eutill/HaDiKo_Humidity_Alarm/(threads)

Thread 1 (2023-11-17):

Board casually resets when trying to read the temperature sensor

eutill, 2023-11-17:
The controller resets when trying to read the temperature sensor.
Here is a log from approx. 70 minutes into normal operation:

```
14:21:08.486 -> RWE	Temperature:20.9 Humidity:75.3
14:21:38.798 -> RWE	Temperature:20.9 Humidity:75.2
14:21:38.862 -> SIL	ALARM NEXT
14:21:38.865 ->
14:21:38.865 -> CTL	Entering state ALARM_PIEZO
14:21:38.894 -> ALA	MAX_CYCLES REACHED
14:21:38.926 ->
14:21:38.926 -> CTL	Entering state ALARM_SILENT
14:22:09.227 -> RWE	Temperature:20.9 Humidity:75.3
14:22:39.543 -> RWE	Temperature:20.9 Humidity:75.2
14:23:09.833 -> RWE	Temperature:20.9 Humidity:75.2
14:23:40.127 -> RWE	Temperature:20.9 Humidity:75.2
14:24:10.427 -> RWE	Temperature:20.9 Humidity:75.2
14:24:40.727 -> RWE	Temperature:20.9 Humidity:75.2
14:25:11.033 -> RWE	Temperature:20.9 Humidity:75.2
14:25:41.327 -> RWE	Temperature:20.9 Humidity:75.2
14:26:11.818 -> STARTUP
14:26:11.818 -> BAT	Battery voltage in mV: 4486.53
14:26:11.884 ->
14:26:11.884 -> CTL	Entering state NO_ALARM
14:26:42.148 -> RWE	Temperature:20.9 Humidity:75.1
14:26:42.214 -> NOA	THR EXC
14:26:42.214 ->
14:26:42.214 -> CTL	Entering state VIGILANCE
14:27:12.509 -> RWE	Temperature:20.9 Humidity:75.1
14:27:42.814 -> RWE	Temperature:21.0 Humidity:75.2
14:27:42.879 -> VIG	ALARM START
14:27:42.884 ->
14:27:42.884 -> CTL	Entering state ALARM_PIEZO
14:27:43.105 -> RWE	Temperature:21.0 Humidity:75.2
14:27:43.138 -> ALA	PIEZO ON
14:27:57.148 -> RWE	Temperature:20.9 Humidity:76.0
14:27:57.180 -> ALA	NEXT SILENT
14:27:57.212 -> ALA	ALARM STOP2
14:27:57.212 ->
14:27:57.212 -> CTL	Entering state ALARM_SILENT
14:28:27.511 -> RWE	Temperature:20.9 Humidity:75.1
14:28:57.810 -> RWE	Temperature:20.9 Humidity:75.1
14:29:28.118 -> RWE	Temperature:20.9 Humidity:75.1
```
The same happened again after approx. one hour.

eutill, 2023-11-17:
In this extreme case, the microcontroller kept resetting numerous times before entering stable operation. Watch how the battery voltage also drops:
```
RWE     Temperature:20.7 Humidity:65.7
RWE     Temperature:20.7 Humidity:65.8
RWE     Temperature:20.7 Humidity:65.8

STARTUP
Reset flags: 100
BAT     Battery voltage in mV: 4471.93

CTL     Entering state NO_ALARM
RWE     Temperature:20.7 Humidity:65.8
NOA     THR EXC

CTL     Entering state VIGILANCE
▒▒▒▒▒▒▒▒▒▒▒
           STARTUP
Reset flags: 100
BAT     Battery voltage in mV: 2972.72

CTL     Entering state NO_ALARM
▒▒▒▒▒▒▒
       STARTUP
Reset flags: 100
BAT     Battery voltage in mV: 3729.17

CTL     Entering state NO_ALARM

STARTUP
Reset flags: 100
BAT     Battery voltage in mV: 3897.98

CTL     Entering state NO_ALARM

STARTUP
Reset flags: 100
BAT     Battery voltage in mV: 4460.07

CTL     Entering state NO_ALARM
RWE     Temperature:20.7 Humidity:65.8
NOA     THR EXC

CTL     Entering state VIGILANCE
RWE     Temperature:20.7 Humidity:65.8
```

eutill, 2023-11-17:
At this point, it was probable that the issue lies in hardware, seeing that the voltage drops when current rises. A look at the battery compartment revealed that a battery contact was corroded. After cleaning, this problem did not arise again.

Closed 2023-11-17.
