eutill/HaDiKo_Humidity_Alarm/HaDiKo_Humidity_Alarm.ino

#include <Adafruit_SSD1306.h>
#include <math.h>
#include <avr/sleep.h>
#include "TempHumSensor.h"


#define ALARM_START_HUMIDITY 65.0f
#define ALARM_END_HUMIDITY 60.0f
#define MEASURE_CYCLE_SEC 60
#define VIGILANCE_DURATION_SEC 60 //should be a multiple of MEASURE_CYCLE_SEC
#define PIEZO_MAX_DURATION_SEC 15 //should be greater than SCREEN_ON_DURATION_SEC
#define PIEZO_OFF_DURATION_SEC 300 //should be a multiple of MEASURE_CYCLE_SEC
#define SCREEN_ON_DURATION_SEC 10
#define MAX_PIEZO_CYCLES 2
#define LOW_BATT_THR 3350.0 //mV, float!

#define PIEZO_PIN 9
#define DISPLAY_VCC_PIN 17
#define DHT_VCC_PIN 16
#define PUSHBUTTON_PIN 2
#define BATT_ADC_PIN A0
#define BATT_VOLT_DIV_GND_PIN 10

//#define APP_DEBUG

#ifdef APP_DEBUG
  #define DEBUG_PRINT(...)		Serial.print(__VA_ARGS__)
  #define DEBUG_PRINTLN(...)		Serial.println(__VA_ARGS__)
#else
  #define DEBUG_PRINT(...)
  #define DEBUG_PRINTLN(...)
#endif


Adafruit_SSD1306 display(128,32);
DHT dht(A1, DHT22);

typedef enum { //don't change order! is being used as index
  STATE_NO_ALARM = 0,
  STATE_VIGILANCE,
  STATE_ALARM_PIEZO,
  STATE_ALARM_SILENT
} alarm_state_t;

const char * alarm_state_str[] = { //don't change order
  "NO_ALARM",
  "VIGILANCE",
  "ALARM_PIEZO",
  "ALARM_SILENT"
};

uint8_t currPiezoCycle = 0;
bool battOk = true;
weatherData_t weather;


bool checkBatt() {
  int i;
  float avgVolt = 0;
  float battVolt;
  unsigned int adcVal;
  analogReference(INTERNAL);
  ADCSRA |= (1 << ADEN);
  pinMode(BATT_VOLT_DIV_GND_PIN, OUTPUT);
  for(i=0;i<10;i++) {
    adcVal = analogRead(BATT_ADC_PIN);
    //discard first five readings due to inaccuracies and average the next 5
    if(i>4) {
      avgVolt += adcVal;
    }
  }
  pinMode(BATT_VOLT_DIV_GND_PIN, INPUT);
  ADCSRA &= ~(1 << ADEN);
  avgVolt /= 5.0;
  avgVolt *= (1080.0/1024.0); //1080 mV is Vref, corresponding to 1024 ADC value
  battVolt = (avgVolt - 22) * 3.32587 + avgVolt; //voltage divider is between Vcc and ~22mV ("GND" on BATT_VOLT_DIV_GND_PIN), 3.32587 is ratio between R1 and R2
  DEBUG_PRINT(F("BAT\tBattery voltage in mV: "));
  DEBUG_PRINTLN(battVolt);

  if(battVolt < LOW_BATT_THR) {
    return false;
  } else {
    return true;
  }
}

bool readWeather(void) {
  pinMode(DHT_VCC_PIN, OUTPUT);
  digitalWrite(DHT_VCC_PIN, HIGH);
  
  dht.begin();
  delay(1000); //DHT needs time to boot

  for(int i=0;i<3;i++) {
    if(dht.readWeather(&weather)) {
      if((weather.humid > 0.0f) && (weather.humid <= 100.0f) && (weather.temp > -20.0f) && (weather.temp < 100.0f)) {
        DEBUG_PRINT(F("RWE\tTemperature:"));
        DEBUG_PRINT(weather.temp, 1);
        DEBUG_PRINT(F(" Humidity:"));
        DEBUG_PRINTLN(weather.humid, 1);

        digitalWrite(DHT_VCC_PIN, LOW);
        pinMode(DHT_VCC_PIN, INPUT);
        return true;
      }
    }
    DEBUG_PRINT(F("RWE\tINV MEAS "));
    DEBUG_PRINTLN(i+1);
    delay(1000);
  }

  digitalWrite(DHT_VCC_PIN, LOW);
  pinMode(DHT_VCC_PIN, INPUT);
  return false;
}

void initScreen(void) {
  display.begin(SSD1306_SWITCHCAPVCC, 0x3C);
  display.clearDisplay();
  display.setTextSize(2);
  display.setTextColor(WHITE);
  display.cp437(true);
  display.setRotation(0);
  display.setCursor(0,0);
  display.clearDisplay();
}

void onOffScreen(bool onOff) {
  if(onOff) {
    pinMode(DISPLAY_VCC_PIN, OUTPUT);
    digitalWrite(DISPLAY_VCC_PIN, LOW); //inverted logic because PNP
    delay(2000); //needs time to boot
    initScreen();
  } else {
    digitalWrite(DISPLAY_VCC_PIN, HIGH); //inverted logic because PNP
    pinMode(DISPLAY_VCC_PIN, INPUT);
    TWCR = 0; //I2C connection reset
    pinMode(18, INPUT);
    digitalWrite(18, LOW);
    pinMode(19, INPUT);
    digitalWrite(19, LOW);
  }
}



void onOffPiezo(bool onOff) {
  if(onOff) {
    pinMode(PIEZO_PIN, OUTPUT);
    digitalWrite(PIEZO_PIN, HIGH);
  } else {
    digitalWrite(PIEZO_PIN, LOW);
    pinMode(PIEZO_PIN, INPUT);
  }
}


ISR(WDT_vect) {}
ISR(INT0_vect) {EIMSK &= ~(1 << INT0);}

bool goToSleep(unsigned int sleepSec) {
#ifdef APP_DEBUG
  Serial.flush();
#endif

  bool buttonPressed = false;

  if (sleepSec < 2) {sleepSec = 2;} //avoid roll-over in next line
  sleepSec = ((sleepSec - 2) / 4) * 4;

  set_sleep_mode(SLEEP_MODE_PWR_DOWN);
  cli();
  //configure watchDog
  MCUSR &= ~(1<<WDRF);
  WDTCSR |= (1<<WDCE) | (1<<WDE);
  WDTCSR = 1<<WDP3; //Watchdog-Dauer (4 sec)
  //configure INT0
  EICRA = (EICRA & ~((1<<ISC00) | (1<<ISC01))); //LOW level interrupt on INT0
  sei();

  //enable watchDog
  WDTCSR |= (1<<WDIE);
  //enable INT0
  EIMSK |= (1<<INT0);

  for(uint8_t i = 0; i<sleepSec/4; i++) {
    cli();
    sleep_enable();
#ifndef APP_DEBUG
    sleep_bod_disable(); //sets BORF in MCUSR - not great for debugging!
#endif
    sei();
    sleep_cpu();
    if(!digitalRead(PUSHBUTTON_PIN)) {
      buttonPressed = true;
      break;
    }
    sleep_disable();
  }
  
  //disable watchDog
  WDTCSR &= ~(1<<WDIE);
  //disable INT0
  EIMSK &= ~(1 << INT0);
  
  if(buttonPressed) {
    DEBUG_PRINTLN(F("SLP\tButton pressed!"));
    onOffPiezo(false);
  }
  
  //returns bool that describes cause of wakeup
  //  true:  button was pressed
  //  false: sleep lasted sleepSec seconds and was woken up by Watchdog timer
  return buttonPressed;
}

bool displayWeather(bool alarm, bool piezo = false) {
  bool buttonPressed = false;

  //power up screen
  onOffScreen(true);
  
  if(alarm) { //Instead of temperature, alarm is printed
    display.println(F("ALARM"));
  } else if(!battOk) {
    display.println(F("Low batt!"));
  } else {
    display.print(F("T "));
    display.print(weather.temp, 1);
    display.print(" ");
    display.write(0xF8);
    display.println("C");
  }
  display.print(F("H "));
  display.print(weather.humid, 1);
  display.print(" % ");
  display.display();

  if(piezo) {
    onOffPiezo(true);
    DEBUG_PRINTLN(F("ALA\tPIEZO ON"));
  }

  unsigned long displayStart = millis();

  while(1) {
    if(!buttonPressed) {
      if(!digitalRead(PUSHBUTTON_PIN)) {
        buttonPressed = true;
        DEBUG_PRINTLN(F("DIS\tButton pressed!"));
        onOffPiezo(false);
      }
    }
    if((millis() - displayStart) >= (SCREEN_ON_DURATION_SEC * (unsigned long) 1000)) { //this is roll-over safe
      break;
    }
  }
  onOffScreen(false);

  return buttonPressed;
}


alarm_state_t stateNoAlarm (void) {
  currPiezoCycle = 0;

  while(1) {
    if(goToSleep(MEASURE_CYCLE_SEC)) { //button pressed
      displayWeather(false);
      if(battOk) {
        battOk = checkBatt();
      }
    }
    if(readWeather()) {
      if((weather.humid >= ALARM_START_HUMIDITY) && battOk) {
        DEBUG_PRINTLN(F("NOA\tTHR EXC"));
        return STATE_VIGILANCE;
      }
    }
  }
}

alarm_state_t stateVigilance (void) {
  const int j = VIGILANCE_DURATION_SEC / MEASURE_CYCLE_SEC;

  for(int i=0;i<j;i++) {
    if(goToSleep(MEASURE_CYCLE_SEC)) { //button pressed, don't count this
      i--;
      displayWeather(true);
    }
    if(readWeather()) {
      if(weather.humid < ALARM_START_HUMIDITY) {
        DEBUG_PRINTLN(F("VIG\tHUM BELOW THR"));
        return STATE_NO_ALARM;
      }
    } else { //read fail, don't count this
      i--;
    }
  }

  //Alarm!
  DEBUG_PRINTLN(F("VIG\tALARM START"));
  return STATE_ALARM_PIEZO;
}

alarm_state_t stateAlarmPiezo (void) {
  if(currPiezoCycle == MAX_PIEZO_CYCLES) {
    DEBUG_PRINTLN(F("ALA\tMAX CYCLES REACHED"));
    return STATE_ALARM_SILENT;
  }

  currPiezoCycle++;
  //Piezo is turned on in displayWeather method

  if(displayWeather(true, true)) { //button pressed, piezo already off
    DEBUG_PRINTLN(F("ALA\tALARM STOP1"));
    return STATE_ALARM_SILENT;
  }

  //At this point, of the PIEZO_MAX_DURATION_SEC, SCREEN_ON_DURATION_SEC have elapsed. The rest of the alarm time needs to be covered by sleep.

  int i, j;
  unsigned int sleepDuration;
  if(MEASURE_CYCLE_SEC > (PIEZO_MAX_DURATION_SEC - SCREEN_ON_DURATION_SEC)) {
    sleepDuration = PIEZO_MAX_DURATION_SEC - SCREEN_ON_DURATION_SEC;
    j = 1;
  } else {
    sleepDuration = MEASURE_CYCLE_SEC;
    j = (PIEZO_MAX_DURATION_SEC - SCREEN_ON_DURATION_SEC) / MEASURE_CYCLE_SEC;
  }
  
  alarm_state_t nextState = STATE_ALARM_SILENT;
 
  for(i=j;i>0;i--) {
    if(goToSleep(sleepDuration)) { //button pressed, mutes piezo
      displayWeather(true);
      break;
    }

    //if this is the last cycle in the loop, mute piezo before reading the weather
    if(i==1) {
      onOffPiezo(false);
    }

    if(!readWeather()) {
      //invalid readings are being ignored instead of returning STATE_NO_ALARM because in this case, after vigilance state, the alarm would go off again, resetting the currPiezoCycle counter. In a constantly moist environment with spurious false readings over a long period of time, this would make the piezo alarm go off more than MAX_PIEZO_CYCLES times.
      DEBUG_PRINTLN(F("ALA\tBAD READ"));
      break;
    }
    if(weather.humid <= ALARM_END_HUMIDITY) {
      DEBUG_PRINTLN(F("ALA\tHUM BEL THR"));
      nextState = STATE_NO_ALARM;
      break;
    }
  }
  
  if(nextState == STATE_ALARM_SILENT) {
    DEBUG_PRINTLN(F("ALA\tNEXT SILENT"));
  }

  DEBUG_PRINTLN(F("ALA\tALARM STOP2"));
  onOffPiezo(false);
  return nextState;
}


alarm_state_t stateAlarmSilent(void) {
  int i;
  const int j = PIEZO_OFF_DURATION_SEC / MEASURE_CYCLE_SEC;
  
  for(i=j;i>0;i--) {
    if(goToSleep(MEASURE_CYCLE_SEC)) { //button pressed
      displayWeather(true);
      i++; //don't count this cycle
    }
    if(!readWeather()) {
      DEBUG_PRINTLN(F("SIL\tBAD READ"));
      i++;
      continue; //invalid readings are being ignored instead of returning STATE_NO_ALARM because in this case, after vigilance state, the alarm would go off again, resetting the currPiezoCycle counter. In a constantly moist environment with spurious false readings over a long period of time, this would make the piezo alarm go off more than MAX_PIEZO_CYCLES times.
    }
    if(weather.humid <= ALARM_END_HUMIDITY) {
      DEBUG_PRINTLN(F("SIL\tHUM BEL THR"));
      return STATE_NO_ALARM;
    }
  }

  DEBUG_PRINTLN(F("SIL\tALARM NEXT"));
  return STATE_ALARM_PIEZO;
}


typedef alarm_state_t (*state_run_t) (void);

state_run_t state_run[] = { //don't change order! index is alarm_state_t
  stateNoAlarm,
  stateVigilance,
  stateAlarmPiezo,
  stateAlarmSilent
};

void setup() {
  // put your setup code here, to run once:
#ifdef APP_DEBUG
  Serial.begin(9600);
  Serial.println(F("\nSTARTUP"));
  Serial.print(F("Reset flags: "));
  Serial.println(MCUSR, BIN); //Reset flags are only valid if device has been programmed via ISP, not with bootloader
  MCUSR = 0x0;
  pinMode(3, OUTPUT); //just to provide an additional ground pin for debugging purposes
#endif

  //provide a short acoustic information that device has (re)started
  onOffPiezo(true);
  delay(500);
  onOffPiezo(false);

  pinMode(PUSHBUTTON_PIN, INPUT_PULLUP);

  battOk = checkBatt();
  ADCSRA &= ~(1 << ADEN); //turn ADC off
  ACSR = (1 << ACD); //turn AC off
}

void loop() {
  // put your main code here, to run repeatedly:
  alarm_state_t currentState;
  while(!readWeather()); //Keep reading sensor as long as reading is invalid
  if((weather.humid >= ALARM_START_HUMIDITY) && battOk) {
    currentState = STATE_VIGILANCE;
  } else {
    currentState = STATE_NO_ALARM;
  }

  while(1) {
    DEBUG_PRINT(F("\nCTL\tEntering state "));
    DEBUG_PRINTLN(alarm_state_str[currentState]);
    currentState = state_run[currentState]();
  }
}
