eutill/HaDiKo_Humidity_Alarm/TempHumSensor.cpp

#include <math.h>
#include "TempHumSensor.h"

DHT::DHT(uint8_t pin, uint8_t type, uint8_t count) {
  _pin = pin;
  _type = type;
  _count = count;
  firstreading = true;
}

void DHT::begin(void) {
  // set up the pins!
  pinMode(_pin, INPUT);
  digitalWrite(_pin, HIGH);
  _lastreadtime = 0;
}

//boolean S == Scale.  True == Fahrenheit; False == Celsius
float DHT::readTemperature(bool S) {
  float f;

  if (read()) {
    switch (_type) {
    case DHT11:
      f = data[2];
      if(S)
        f = convertCtoF(f);
      return f;
    case DHT22:
    case DHT21:
      f = data[2] & 0x7F;
      f *= 256;
      f += data[3];
      f /= 10;
      if (data[2] & 0x80)
        f *= -1;
      if(S)
        f = convertCtoF(f);
      return f;
    }
  }
  //Serial.print("Read fail");
  return NAN;
}

float DHT::convertCtoF(float c) {
  return c * 9 / 5 + 32;
}

float DHT::readHumidity(void) {
  float f;
  if (read()) {
    switch (_type) {
    case DHT11:
      f = data[0];
      return f;
    case DHT22:
    case DHT21:
      f = data[0];
      f *= 256;
      f += data[1];
      f /= 10;
      return f;
    }
  }
  //Serial.print("Read fail");
  return NAN;
}

bool DHT::readWeather(weatherData_t *myWeather, bool S) {
  if(myWeather == NULL)  {
    return false;
  }
  if(!read()) {
    return false;
  }
  float f;
  switch(_type) {
    case DHT11:
      myWeather->humid = data[0];
      f = data[2];
      if(S) {
        f = convertCtoF(f);
      }
      myWeather->temp = f;
      return true;
    case DHT22:
    case DHT21:
      f = data[0];
      f *= 256;
      f += data[1];
      f /= 10;
      myWeather->humid = f;
      f = data[2] & 0x7F;
      f *= 256;
      f += data[3];
      f /= 10;
      if (data[2] & 0x80)
        f *= -1;
      if(S)
        f = convertCtoF(f);
      myWeather->temp = f;
      return true;
  }
  return false;
}


boolean DHT::read(void) {
  uint8_t laststate = HIGH;
  uint8_t counter = 0;
  uint8_t j = 0, i;
  unsigned long currenttime;

  // pull the pin high and wait 250 milliseconds
  digitalWrite(_pin, HIGH);
  delay(250);

  currenttime = millis();
  if (currenttime < _lastreadtime) {
    // ie there was a rollover
    _lastreadtime = 0;
  }
  if (!firstreading && ((currenttime - _lastreadtime) < 2000)) {
    digitalWrite(_pin, LOW);
    return true; // return last correct measurement
    //delay(2000 - (currenttime - _lastreadtime));
  }
  firstreading = false;

  _lastreadtime = millis();

  data[0] = data[1] = data[2] = data[3] = data[4] = 0;
  
  // now pull it low for ~20 milliseconds
  pinMode(_pin, OUTPUT);
  digitalWrite(_pin, LOW);
  delay(20);
  //cli();
  digitalWrite(_pin, HIGH);
  delayMicroseconds(40);
  pinMode(_pin, INPUT);

  // read in timings
  for ( i=0; i< MAXTIMINGS; i++) {
    counter = 0;
    while (digitalRead(_pin) == laststate) {
      counter++;
      delayMicroseconds(1);
      if (counter == 255) {
        break;
      }
    }
    laststate = digitalRead(_pin);

    if (counter == 255) break;

    // ignore first 3 transitions
    if ((i >= 4) && (i%2 == 0)) {
      // shove each bit into the storage bytes
      data[j/8] <<= 1;
      if (counter > _count)
        data[j/8] |= 1;
      j++;
    }

  }

  digitalWrite(_pin, LOW);

  //sei();


  // check we read 40 bits and that the checksum matches
  if ((j >= 40) && 
      (data[4] == ((data[0] + data[1] + data[2] + data[3]) & 0xFF)) ) {
    return true;
  }
  

  return false;

}
