eutill/HaDiKo_Humidity_Alarm/(commit log)

2023-01-09 Power saving
2023-01-09 Incorporated weather sensor library
2023-02-11 adjustments for first working prototype
2023-02-21 Piezo: important bugfixes and introduction of limitation of piezo cycles during one alarm
    [HaDiKo_Humidity_Alarm.ino]
2023-02-24 Added battery monitoring
2023-02-24 Adjustments ADC
2023-02-24 Adjustments ADC part 2
2023-02-24 Final adjustments ADC part 3
2023-11-07 Avoid piezo alarm going off due to invalid reading even though MAX_PIEZO_CYCLES have been reached
    [HaDiKo_Humidity_Alarm.ino]
2023-11-07 minor changes in debug prints
